wyolum/pulse_v2/README.md

pulse_v2
========

motorcycle breathing LED light using ATTiny45. ver 2 uses SMD components. ver 3 uses through hole components
