wyolum/pulse_v2/kicad/pulse_v2_Images/pulse_02.png

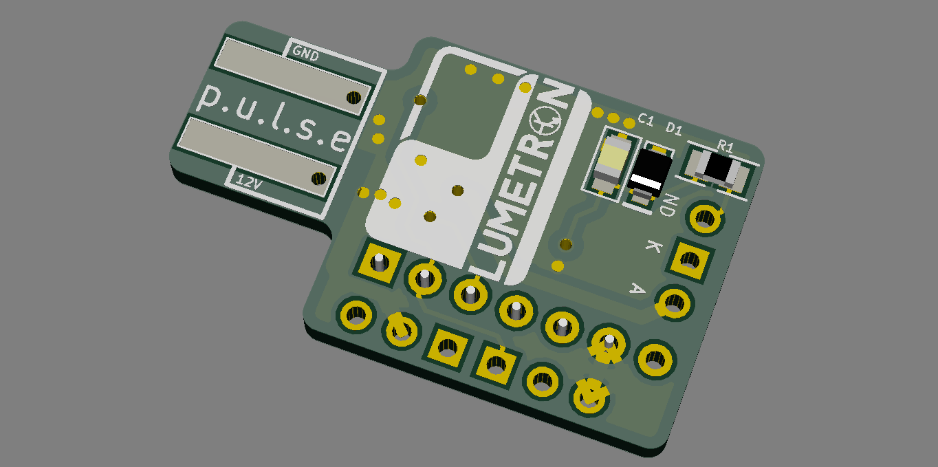
kicad/pulse_v2_Images/pulse_02.png
