wyolum/pulse_v2/kicad/BoM_pulse_v2.xls

Reference | Value | Footprint | Datasheet
C1 | 10n | pulse:c_0805
C2, C4 | 100n | pulse:c_0805
C3 | 4u7 | pulse:c_0805
D1 | Z4V7 | pulse:SOD323F | MM3Z4V7C
D3 | MBR0530T3G | pulse:SOD123
Q1 | ZXMN10A07F | pulse:SOT23-3
R1 | 4k7 | pulse:r_0805_2
R3 | 2k2 | pulse:r_0805_2
U1 | ATTINY45-20SU | pulse:SO8E
U2 | MCP1754ST | pulse:SOT23-3
