wyolum/pulse_v2/kicad/BoM_pulse_v2_octopart.xls

Item No | Reference | Qty | Catalog | Description | Value | Package | Mfr Name | Mfr P/N | Distributor | Distributor P/N
1 | C1 | 1 | Capacitor | CAP CER 10000PF 16V 10% X7R 0805 | 10nF | 0805 (2012 Metric) | Kemet | C0805C103K4RACTU | Digikey | 399-7995-1-ND
2 | C2, C4 | 2 | Capacitor | CAP CER 0.1UF 16V 10% X7R 0805 | 100n | 0805 (2012 Metric) | Samsung Electro-Mechanics America, Inc | CL21B104KOANNNC | Digikey | 1276-2448-1-ND
3 | C3 | 1 | Capacitor | CAP CER 4.7UF 35V 10% X7R 0805 | 4u7 | 0805 (2012 Metric) | TDK Corporation | C2012X7R1V475K125AC | Digikey | 445-7555-1-ND
4 | D1 | 1 | Diode | DIODE ZENER 4.7V 200MW SOD323F | Z4V7 , MM3Z4V7C | SC-90, SOD-323F | Fairchild Semiconductor | MM3Z4V7C | Digikey | MM3Z4V7CCT-ND
5 | D3 | 1 | Diode | DIODE SCHOTTKY 30V 0.5A SOD123 | MBR0530T3G | SOD-123 | ON Semiconductor | MBR0530T3G | Digikey | MBR0530T3GOSCT-ND
6 | Q1 | 1 | Transistor | MOSFET N-CH 100V 700MA SOT23-3 | ZXMN10A07F | TO-236-3, SC-59, SOT-23-3 | Diodes Incorporated | ZXMN10A07FTA | Digikey | ZXMN10A07FCT-ND
7 | R1 | 1 | Resister | RES 4.7K OHM 1/8W 5% 0805 | 4k7 | 0805 (2012 Metric) | Stackpole Electronics Inc | RMCF0805JT4K70 | Digikey | RMCF0805JT4K70CT-ND
8 | R3 | 1 | Resister | RES 2.2K OHM 1/8W 5% 0805 | 2k2 | 0805 (2012 Metric) | Stackpole Electronics Inc | RMCF0805JT2K20 | Digikey | RMCF0805JT2K20CT-ND
9 | U1 | 1 | IC | IC MCU 8BIT 4KB FLASH 8SOIC | ATTINY45-20SU | 8-SOIC (0.209", 5.30mm Width) | Atmel | ATTINY45-20SUR | Digikey | ATTINY45-20SURCT-ND
10 | U2 | 1 | IC | IC REG LDO 5V 0.15A SOT23A-3 | MCP1754ST | TO-236-3, SC-59, SOT-23-3 | Microchip Technology | MCP1754ST-5002E/CB | Digikey | MCP1754ST-5002E/CBCT-ND
