wyolum/pulse_v2/kicad/BoM_pulse_v2_Seeed.ods

Electronic Engineering BOM List
Product Name： p.u.l.s.e
Version：v2
Issue Date：7/Jul/2014
Item No. (序号) | Reference Des (上件位置) | Qty (用量) | Catalog (分类） | Part_Description (规格描述) | Part_Value （元件值） | Part_Package （元件封装） | Manufacturers Name (使用厂牌名称) | Manufacturers Part No. (使用厂牌型号) | Distributors Name （供应商名称） | Distributors Part No. (供貨商型号) | Unit Price （单价） | Price Break To Use （价格分段的购买量） | Notes/Remark （备注）
Example（填写范例）
1 | C1 | 1 | Capacitor | CAP CER 10000PF 16V 10% X7R 0805 | 10nF | 0805 (2012 Metric) | Kemet | C0805C103K4RACTU | Digikey | 399-7995-1-ND |  |  | http://www.digikey.com/product-detail/en/C0805C103K4RACTU/399-7995-1-ND/3471718
2 | C2, C4 | 2 | Capacitor | CAP CER 0.1UF 16V 10% X7R 0805 | 100n | 0805 (2012 Metric) | Samsung Electro-Mechanics America, Inc | CL21B104KOANNNC | Digikey | 1276-2448-1-ND |  |  | http://www.digikey.com/product-detail/en/CL21B104KOANNNC/1276-2448-1-ND/3890534
3 | C3 | 1 | Capacitor | CAP CER 4.7UF 35V 10% X7R 0805 | 4u7 | 0805 (2012 Metric) | TDK Corporation | C2012X7R1V475K125AC | Digikey | 445-7555-1-ND |  |  | http://www.digikey.com/product-detail/en/C2012X7R1V475K125AC/445-7555-1-ND/2733627
4 | D1 | 1 | Diode | DIODE ZENER 4.7V 200MW SOD323F | Z4V7 , MM3Z4V7C | SC-90, SOD-323F | Fairchild Semiconductor | MM3Z4V7C | Digikey | MM3Z4V7CCT-ND |  |  | http://www.digikey.com/product-detail/en/MM3Z4V7C/MM3Z4V7CCT-ND/1626894
5 | D3 | 1 | Diode | DIODE SCHOTTKY 30V 0.5A SOD123 | MBR0530T3G | SOD-123 | ON Semiconductor | MBR0530T3G | Digikey | MBR0530T3GOSCT-ND |  |  | http://www.digikey.com/product-detail/en/MBR0530T3G/MBR0530T3GOSCT-ND/2705023
6 | Q1 | 1 | Transistor | MOSFET N-CH 100V 700MA SOT23-3 | ZXMN10A07F | TO-236-3, SC-59, SOT-23-3 | Diodes Incorporated | ZXMN10A07FTA | Digikey | ZXMN10A07FCT-ND |  |  | http://www.digikey.com/product-detail/en/ZXMN10A07FTA/ZXMN10A07FCT-ND/386063
7 | R1 | 1 | Resister | RES 4.7K OHM 1/8W 5% 0805 | 4k7 | 0805 (2012 Metric) | Stackpole Electronics Inc | RMCF0805JT4K70 | Digikey | RMCF0805JT4K70CT-ND |  |  | http://www.digikey.com/product-detail/en/RMCF0805JT4K70/RMCF0805JT4K70CT-ND/1942570
8 | R3 | 1 | Resister | RES 2.2K OHM 1/8W 5% 0805 | 2k2 | 0805 (2012 Metric) | Stackpole Electronics Inc | RMCF0805JT2K20 | Digikey | RMCF0805JT2K20CT-ND |  |  | http://www.digikey.com/product-detail/en/RMCF0805JT2K20/RMCF0805JT2K20CT-ND/1942563
9 | U1 | 1 | IC | IC MCU 8BIT 4KB FLASH 8SOIC | ATTINY45-20SU | 8-SOIC (0.209", 5.30mm Width) | Atmel | ATTINY45-20SUR | Digikey | ATTINY45-20SURCT-ND |  |  | http://www.digikey.com/product-detail/en/ATTINY45-20SUR/ATTINY45-20SURCT-ND/3440769
10 | U2 | 1 | IC | IC REG LDO 5V 0.15A SOT23A-3 | MCP1754ST | TO-236-3, SC-59, SOT-23-3 | Microchip Technology | MCP1754ST-5002E/CB | Digikey | MCP1754ST-5002E/CBCT-ND |  |  | http://www.digikey.com/product-detail/en/MCP1754ST-5002E%2FCB/MCP1754ST-5002E%2FCBCT-ND/2783141
1. Recommended Distributor: Digi-Key, Mouser, Avnet Express, Farnell.
2. Catalog: Capacitor,Resister,Diode,Connector,Transistor,IC,PROTECTOR CATEGORY,OTHER
3. Required Fields: Item No, Reference Des, Qty, Catalog, Part_Value, Part Package
Optional Fields: Part_Description, Manufacturers Name, Manufacturers Part No, Distributors Name, Distributors Part No, Unit Cost, Price break to use, Notes/Remark
