wyolum/pulse_v2/kicad/pulse_v2_BoM.ods

Sheet: Final_BoM
BoM, for kit building assembly |  |  |  |  |  |  |  |  | 5.05 | 4.54
ref | value | MODULE | Manufacturer | Mfr. P/N | Vendor | Vendor P/N | NOTE1 | QTY | RATE | AMOUNT
C1 | 10n | c_0805 | Kemet | C0805C103K5RACTU | DigiKey (http://www.digikey.com/product-detail/en/C0805C103K5RACTU/399-1158-1-ND/411433) | 399-1158-1-ND | Decoupling capacitor, Ceramic | 1 | 0.05 | 0.05
C2 | 100n | c_0805 | Kemet | C0805C104K3RACTU | DigiKey (http://www.digikey.com/product-detail/en/C0805C104K3RACTU/399-1168-1-ND/411443) | 399-1168-1-ND | Decoupling capacitor, Ceramic | 1 | 0.07 | 0.07
D1 | Z5V1 | SOD323F | Fairchild Semiconductor | MM3Z5V1C | DigiKey (http://www.digikey.com/product-detail/en/MM3Z5V1C/MM3Z5V1CCT-ND/1626900) | MM3Z5V1CCT-ND | input protection diode | 1 | 0.20 | 0.20
D2 | Z5V1 | SOD323F | Fairchild Semiconductor | MM3Z5V1C | DigiKey (http://www.digikey.com/product-detail/en/MM3Z5V1C/MM3Z5V1CCT-ND/1626900) | MM3Z5V1CCT-ND | 5V regulation diode | 1 | 0.20 | 0.20
D3 | 1N4448WT | SOD523F | Fairchild Semiconductor | 1N4448WT | DigiKey (http://www.digikey.com/product-detail/en/1N4448WT/1N4448WTCT-ND/1966596) | 1N4448WTCT-ND | reverse polarity protection diode | 1 | 0.17 | 0.17
K2 | ISP | pin_strip_6b | Sullins Connector Solutions | PREC040SAAN-RC | DigiKey (http://www.digikey.com/product-detail/en/PREC040SAAN-RC/S1012EC-40-ND/2774814) | S1012EC-40-ND | Header, Male, 8x1 – K2+P1+P3 | 1 | 0.51 | 0.00
P1 | LAMP | pin_strip_2 | -- | -- | -- | -- | PCB edge fits Lamp T10 connector | 1 | 0.00 | 0.00
P2 | 12V | Header_12V | -- | -- | -- | -- | see K2 | 1 | 0.00 | 0.00
P3 | ND | Pad01 | -- | -- | -- | -- | see K2 | 1 | 0.00 | 0.00
PB3 | ND | Pad01 | -- | -- | -- | -- | breakout pad | 1 | 0.00 | 0.00
PCB1 | PCB | PCB | seeed | -- | -- | -- | -- | 1 | 2.38 | 2.38
Q1 | 2N7000 | SOT23-3 | Toshiba | SSM3K7002BF(T5L,F) | DigiKey (http://www.digikey.com/product-detail/en/SSM3K7002BF(T5L,F)/SSM3K7002BF(T5LF)CT-ND/969393) | SSM3K7002BF(T5LF)CT-ND |  | 1 | 0.35 | 0.35
R1 | 4K7 | r_0805 | Stackpole Electronics Inc | RMCF0805JT4K70 | DigiKey (http://www.digikey.com/product-detail/en/RMCF0805JT4K70/RMCF0805JT4K70CT-ND/1942570) | RMCF0805JT4K70CT-ND |  | 1 | 0.03 | 0.03
R2 | 4K7 | r_0805 | Stackpole Electronics Inc | RMCF0805JT4K70 | DigiKey (http://www.digikey.com/product-detail/en/RMCF0805JT4K70/RMCF0805JT4K70CT-ND/1942570) | RMCF0805JT4K70CT-ND |  | 1 | 0.03 | 0.03
R3 | 2k2 | r_0805 | Stackpole Electronics Inc | RMCF0805JT2K20 | DigiKey (http://www.digikey.com/product-detail/en/RMCF0805JT2K20/RMCF0805JT2K20CT-ND/1942563) | RMCF0805JT2K20CT-ND |  | 1 | 0.03 | 0.03
U1 | ATTINY45-20SU | SO8E | Atmel | ATTINY45-20SU | DigiKey (http://www.digikey.com/product-detail/en/ATTINY45-20SU/ATTINY45-20SU-ND/735466) | ATTINY45-20SU-ND |  | 1 | 1.03 | 1.03

Sheet: BoM_SCH
ref | value | footprint | Field1 | Field2 | Field3 | Field4 | Field5 | Field6 | Field7 | Field8
C1 | 10n | c_0805
C2 | 100n | c_0805
D1 | Z5V1 | SOD323F
D2 | Z5V1 | SOD323F
D3 | 1N4448WT | SOD523F
K2 | ISP | pin_strip_6b
P1 | LAMP | pin_strip_2
P2 | 12V | Header_12V
P3 | ND | Pad01
PB3 | ND | Pad01
PCB1 | PCB | PCB
Q1 | 2N7000 | SOT23-3
R1 | 4K7 | r_0805
R2 | 4K7 | r_0805
R3 | 2k2 | r_0805
U1 | ATTINY45-20SU | SO8E

Sheet: BoM_PCB
Id | Designator | Package | Quantity | Designation | Supplier and ref
1 | C1 | c_0805 | 1 | 10n
2 | C2 | c_0805 | 1 | 100n
3 | D1,D2 | SOD323F | 2 | Z5V1
4 | D3 | SOD523F | 1 | 1N4448WT
5 | K2 | pin_strip_6b | 1 | ISP
6 | P1 | pin_strip_2 | 1 | LAMP
7 | P2 | Header_12V | 1 | 12V
8 | P3,PB3 | Pad01 | 1 | ND
9 | PCB1 | PCB | 1 | PCB
10 | Q1 | SOT23-3 | 1 | 2N7000
11 | R1,R2 | r_0805 | 2 | 4K7
12 | R3 | r_0805 | 1 | 2k2
13 | U1 | SO8E | 1 | ATTINY45-20SU
