wyolum/pulse_v2/kicad/pulse_v2.pdf

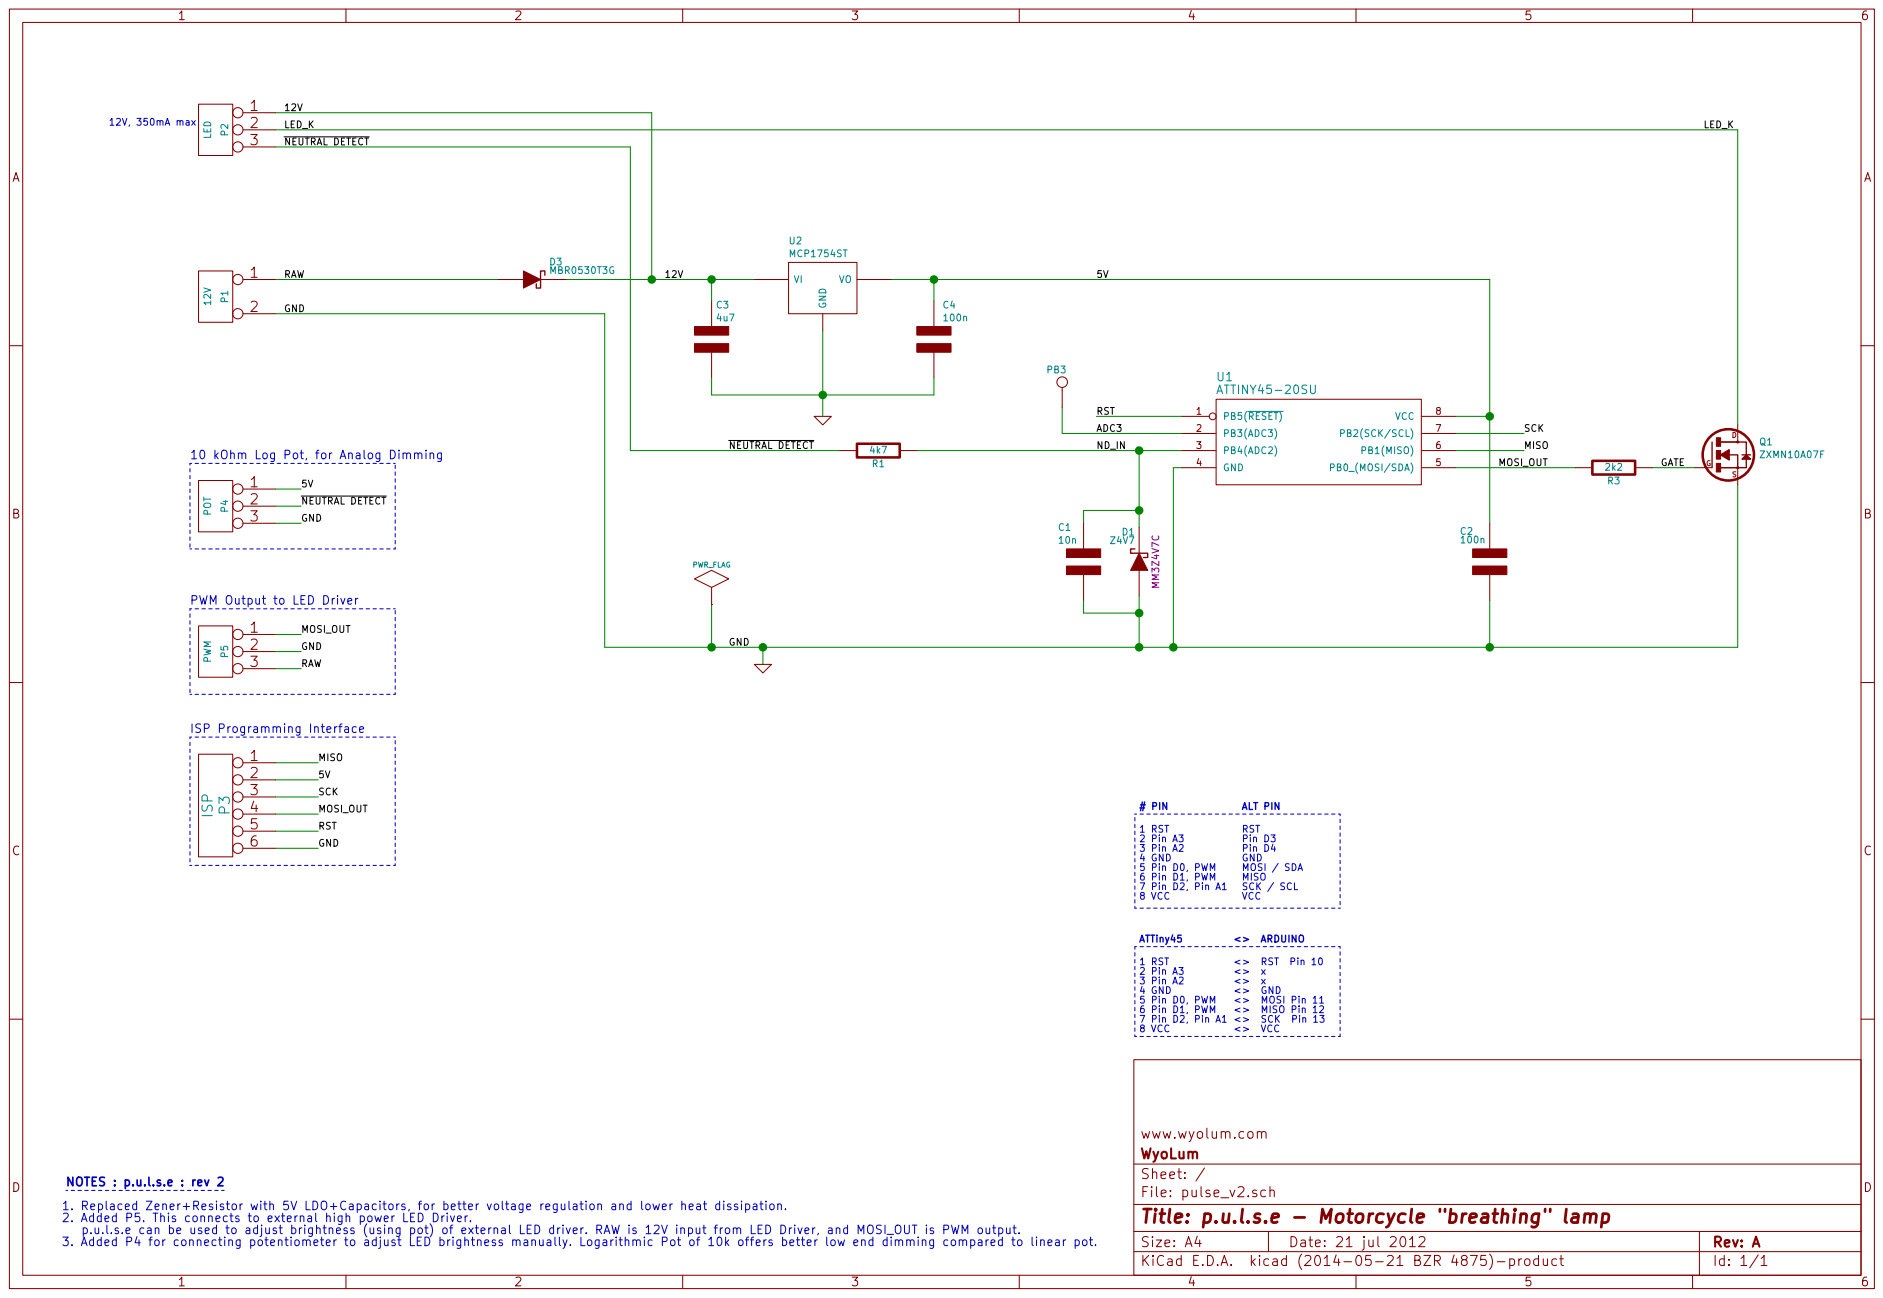
[picture p4: page 1]

10 kOhm Log Pot, for Analog Dimming 1
ISP Programming Interface 1

RST Pin D3 Pin D4 GND MOSI / SDA MISO

<> MOSI Pin 11 <> MISO Pin 12 <> SCK Pin 13 <> VCC

www.wyolum.com
File: pulse_v2.sch Sheet: / WyoLum

NOTES : p.u.l.s.e : rev 2
1. Replaced Zener+Resistor with 5V LDO+Capacitors, for better voltage regulation and lower heat dissipation.
2. Added P5. This connects to external high power LED Driver.
p.u.l.s.e can be used to adjust brightness (using pot) of external LED driver. RAW is 12V input from LED Driver, and MOSI_OUT is PWM output.
3. Added P4 for connecting potentiometer to adjust LED brightness manually. Logarithmic Pot of 10k offers better low end dimming compared to linear pot.

Id: 1/1 Title: p.u.l.s.e - Motorcycle "breathing" lamp
