wyolum/pulse_v2/kicad/pulse_v2.sch

## KiCad design kicad/pulse_v2.sch (2014-07-11)

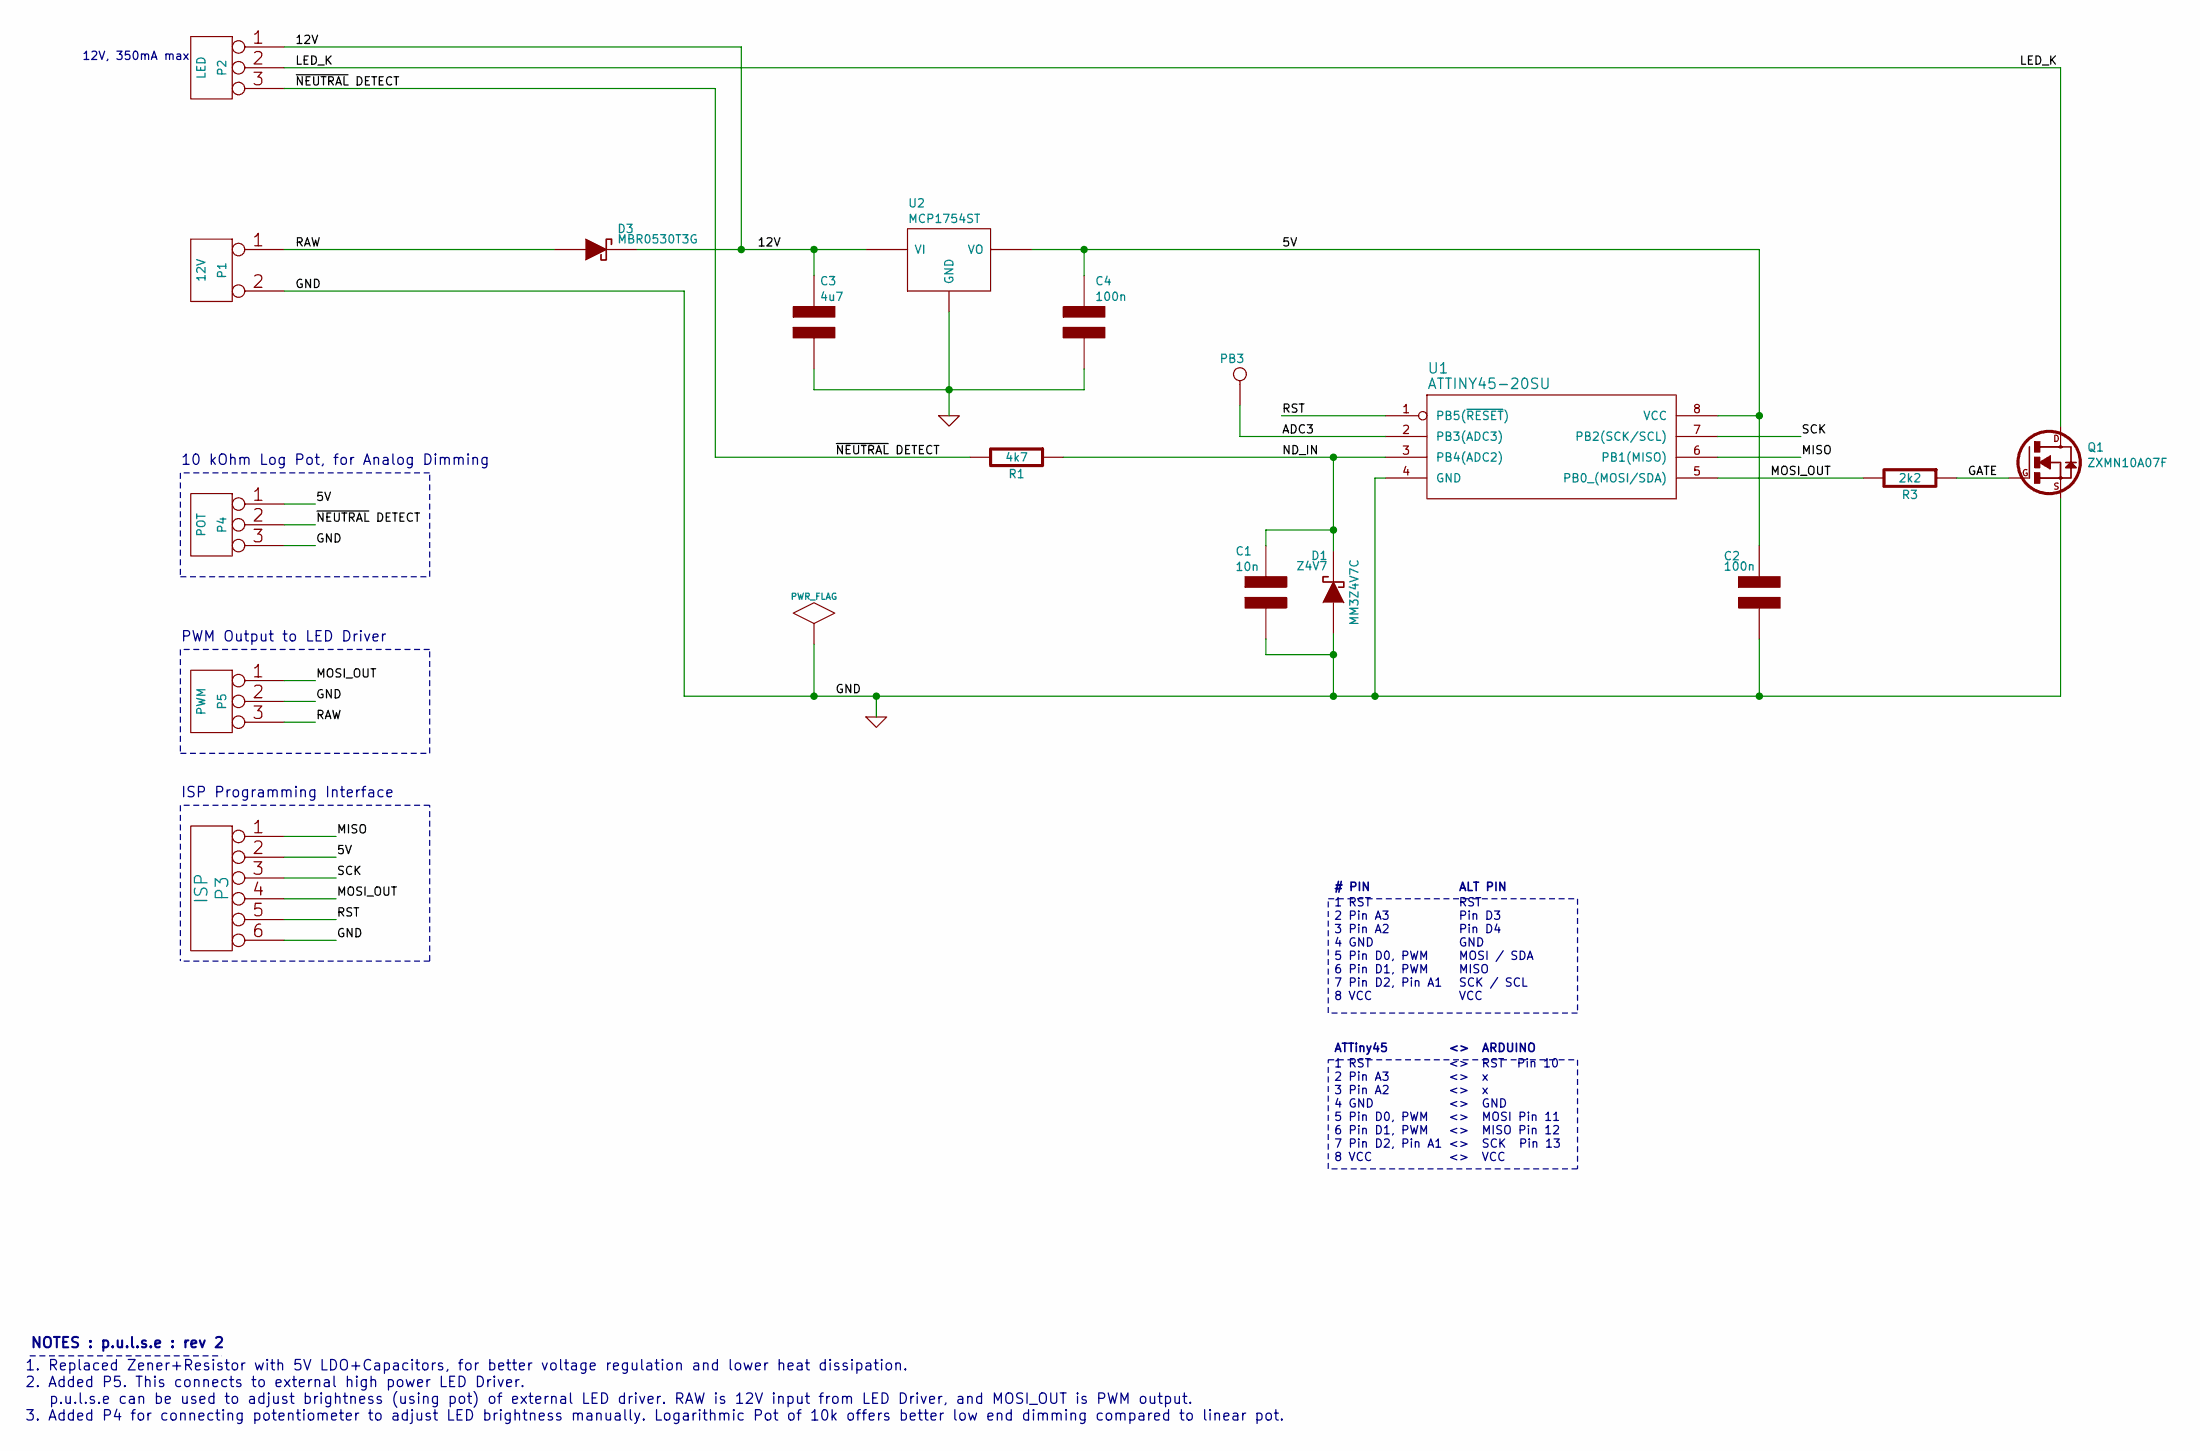
[picture p10: schematic pulse_v2.sch]

Parts:
C1: 10n; c_0805
C2, C4: 100n; c_0805
C3: 4u7; c_0805
D1: Z4V7; SOD323F
D3: MBR0530T3G; SOD123
P1: 12V; Header_12V
P2: LED; pin_strip_3
P3: ISP; pin_strip_6b
P4: POT; pin_strip_3
P5: PWM; pin_strip_3
PB3: ADC3; Pad01
Q1: ZXMN10A07F; SOT23-3
R1: 4k7; r_0805_2
R3: 2k2; r_0805_2
U1: ATTINY45-20SU; SO8E
U2: MCP1754ST; SOT23-3

Connections:
5V: C2.1, C4.1, P3.2, P4.1, U1.8 (VCC), U2.3 (VO)
12V: C3.1, D3.2 (K), P2.1, U2.2 (VI)
ADC3: PB3.1, U1.2 (PB3(ADC3))
GATE: Q1.1 (G), R3.1
GND: C1.2, C2.2, C3.2, C4.2, D1.1 (A), P1.2 (PM), P3.6, P4.3, P5.2 (PM), Q1.3 (S), U1.4 (GND), U2.1 (GND)
LED_K: P2.2 (PM), Q1.2 (D)
MISO: P3.1, U1.6 (PB1(MISO))
MOSI_OUT: P3.4, P5.1, R3.2, U1.5 (PB0_(MOSI/SDA))
ND_IN: C1.1, D1.2 (K), R1.1, U1.3 (PB4(ADC2))
RAW: D3.1 (A), P1.1, P5.3
RST: P3.5, U1.1 (PB5(~RESET))
SCK: P3.3, U1.7 (PB2(SCK/SCL))
~NEUTRAL DETECT: P2.3, P4.2 (PM), R1.2

Notes on the sheet:
12V, 350mA max
ISP Programming Interface
10 kOhm Log Pot, for Analog Dimming
PWM Output to LED Driver
1 RST 2 Pin A3 3 Pin A2 4 GND 5 Pin D0, PWM 6 Pin D1, PWM 7 Pin D2, Pin A1 8 VCC
RST Pin D3 Pin D4 GND MOSI / SDA MISO SCK / SCL VCC
<> RST Pin 10 <> x <> x <> GND <> MOSI Pin 11 <> MISO Pin 12 <> SCK Pin 13 <> VCC
# PIN
ALT PIN
ATTiny45
<> ARDUINO
1. Replaced Zener+Resistor with 5V LDO+Capacitors, for better voltage regulation and lower heat dissipation. 2. Added P5. This connects to external high power LED Driver. p.u.l.s.e can be used to adjust brightness (using pot) of external LED driver. RAW is 12V input from LED Driver, and MOSI_OUT is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
NOTES : p.u.l.s.e : rev 2
